axelaberg91/watchsync/website/site/assets/product-usb.webp

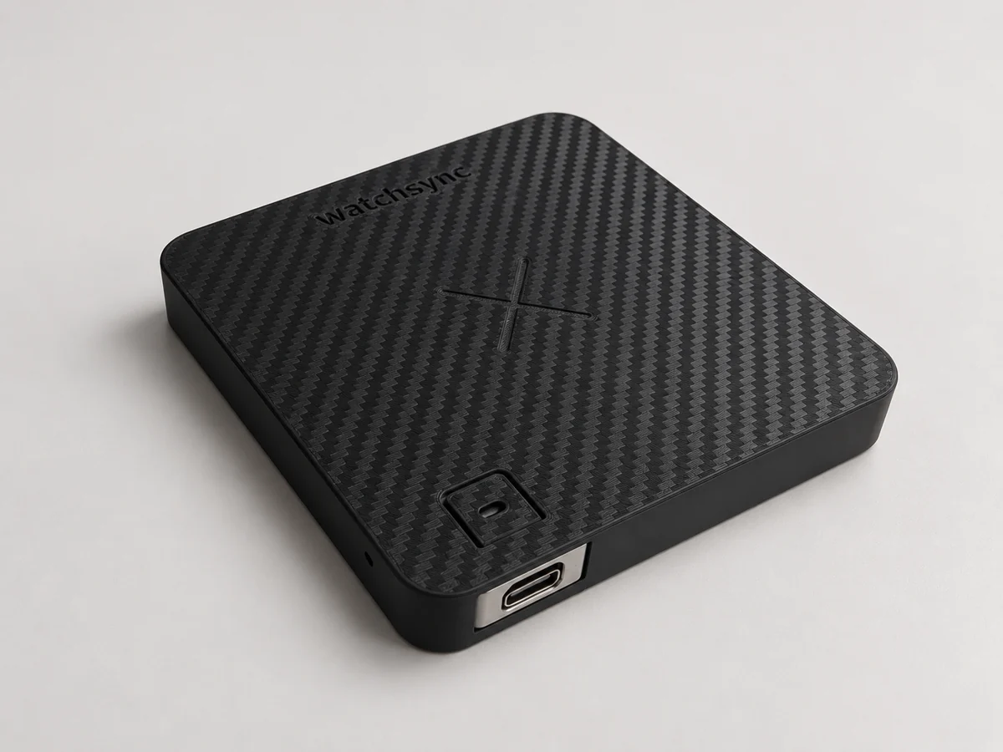
website/site/assets/product-usb.webp
