axelaberg91/watchsync/website/site/assets/product-hero.webp

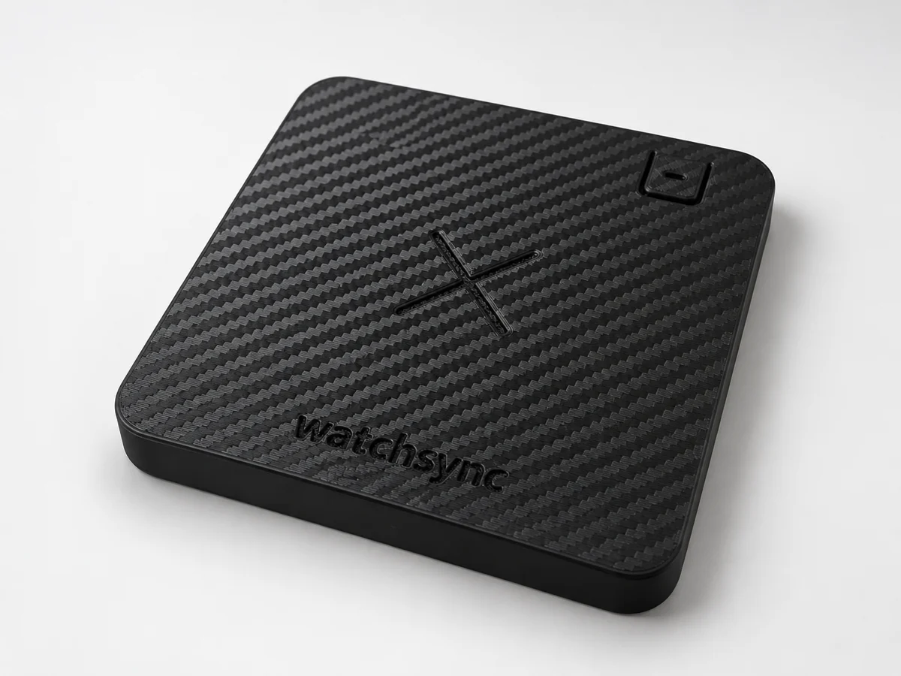
website/site/assets/product-hero.webp
