axelaberg91/watchsync/website/site/assets/product-underside.webp

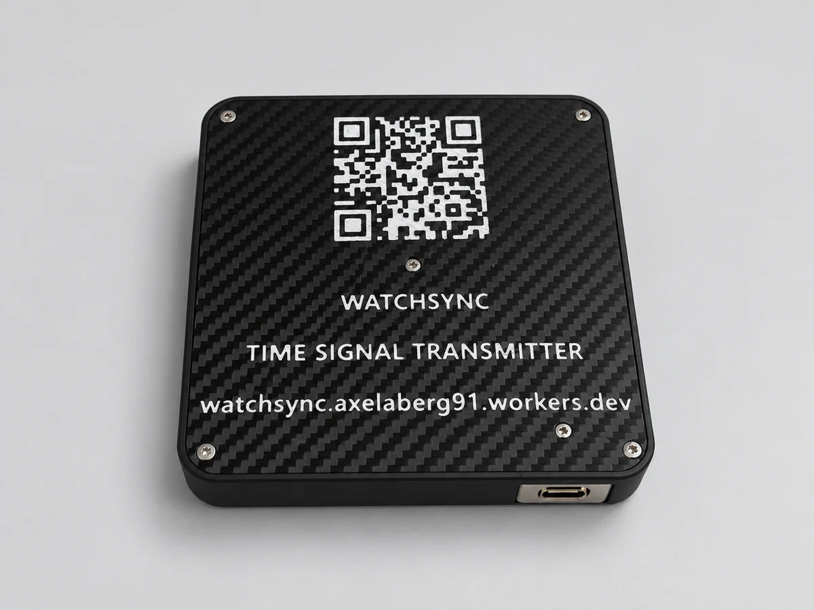
website/site/assets/product-underside.webp
