axelaberg91/watchsync/hardware/watchsync-bobbin.stl

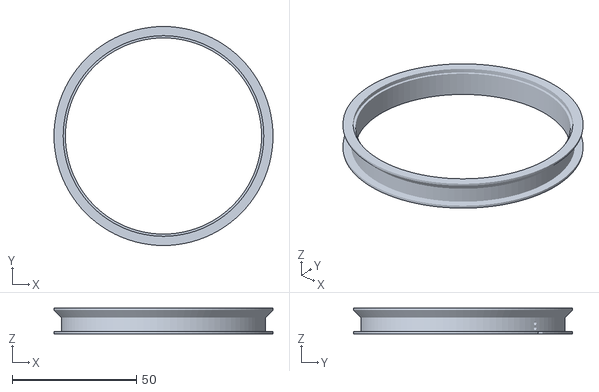
[picture p4: CAD file, 2026-11-01]
hardware/watchsync-bobbin.stl
88.0 x 88.0 x 10.3
