axelaberg91/watchsync/hardware/watchsync-lid.stl

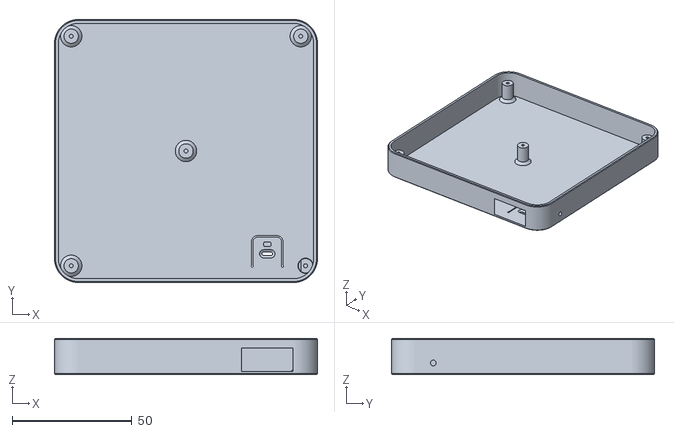
[picture p5: CAD file, 2026-11-01]
hardware/watchsync-lid.stl
110.0 x 110.0 x 15.2
