axelaberg91/watchsync/hardware/watchsync-base.stl

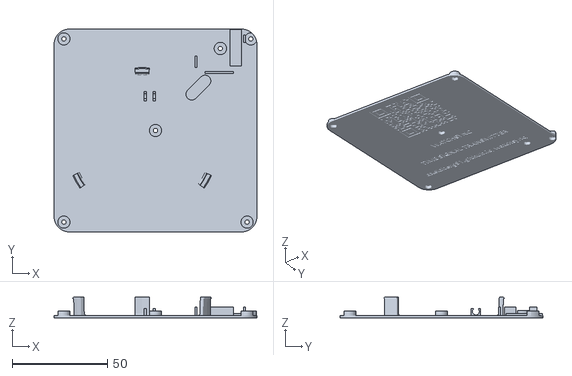
[picture p6: CAD file, 2026-11-01]
hardware/watchsync-base.stl
106.4 x 106.4 x 10.9
