axelaberg91/watchsync/website/site/assets/assembly.webp

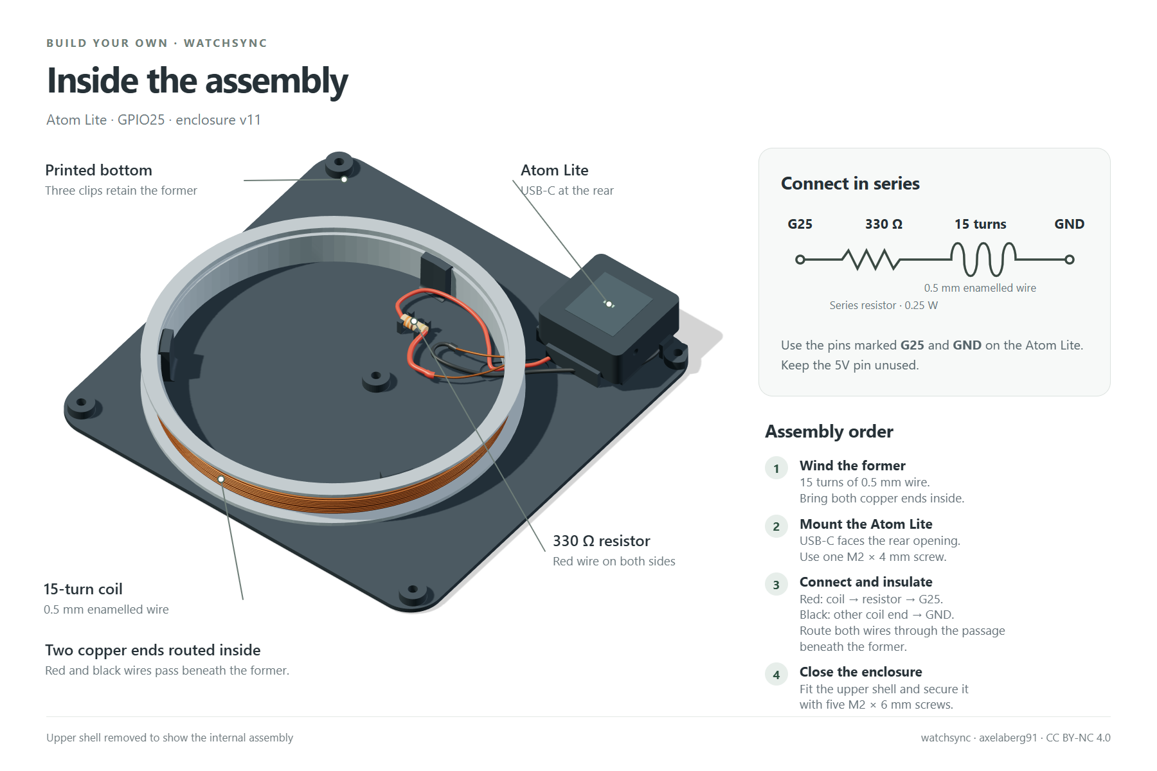
website/site/assets/assembly.webp
