axelaberg91/watchsync/(commit log)

2026-10-29 Prepare clean public firmware, website and hardware repository
    [watchsync-enclosure.scad]
2026-10-29 Stage verified 1.12.2 release downloads in both website languages
2026-10-29 Align contributor language policy with current preferences
2026-11-01 Prepare GitHub Pages hosting and update firmware and enclosure links
    [watchsync-enclosure.scad]
2026-11-01 Publish current downloads and remove obsolete Worker hosting
2026-11-01 Keep current printable STL parts in the hardware directory
    [watchsync-base.stl, watchsync-bobbin.stl, watchsync-lid.stl]
2026-11-11 Stage firmware 1.13.0 downloads and update related bilingual guides
2026-11-13 Add a bounded device event log under Advanced
